portugal-online/uair-sat-hardware/schematics/uAir2_schematics.pdf

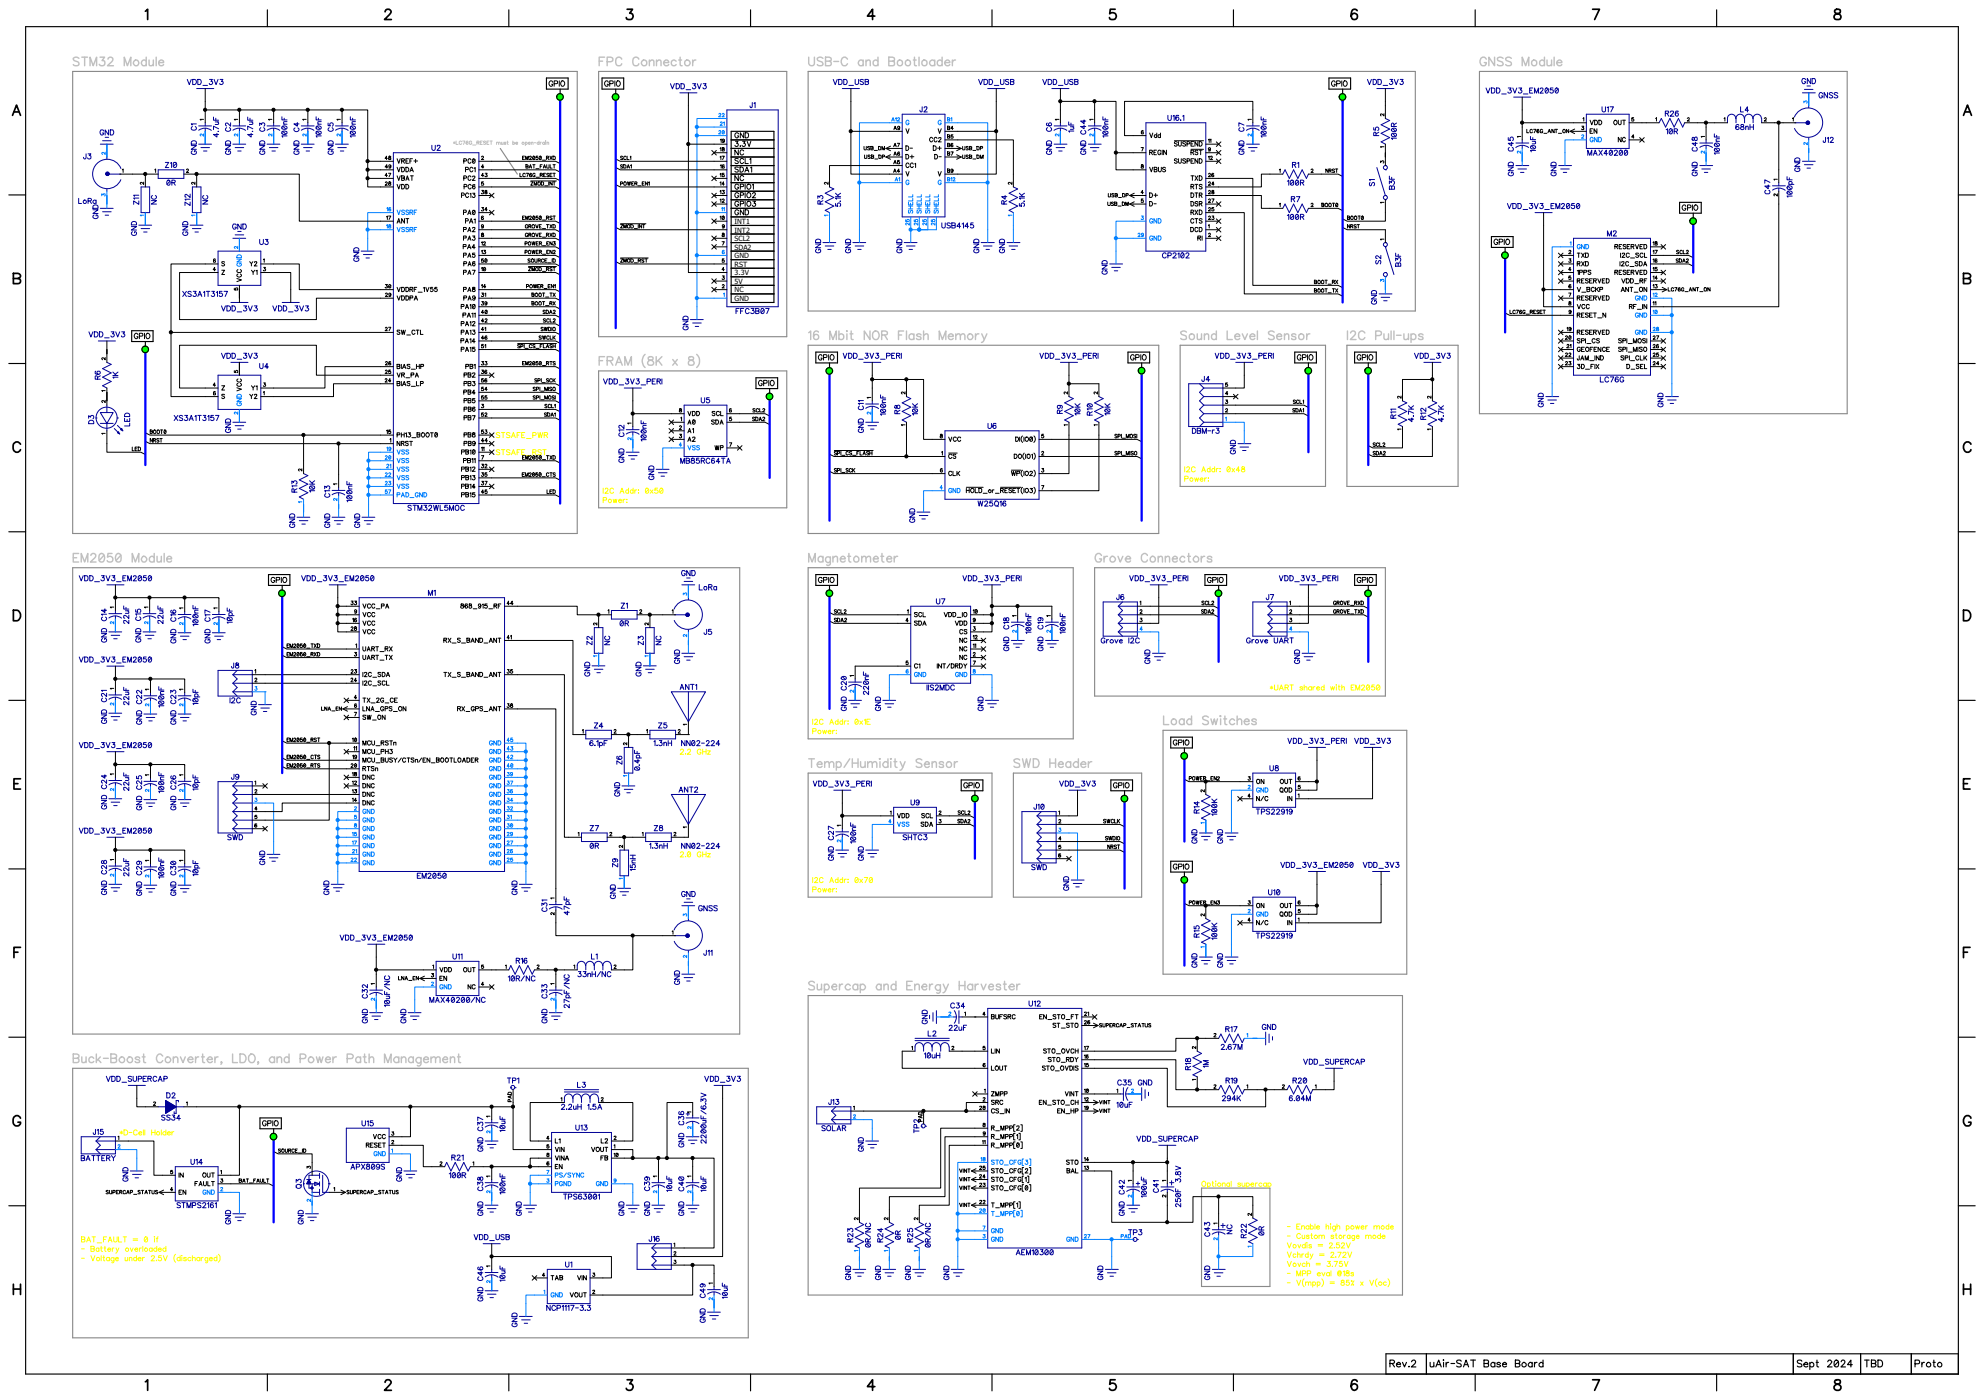
[picture p1: page 1]
INT1 INT2 SCL2 SDA2 GND RST 3.3V 5V NC GND
