portugal-online/uair-sat-hardware/docs/uAir-Sat Block Diagram Rev2.pdf

# uAir-Sat Rev2

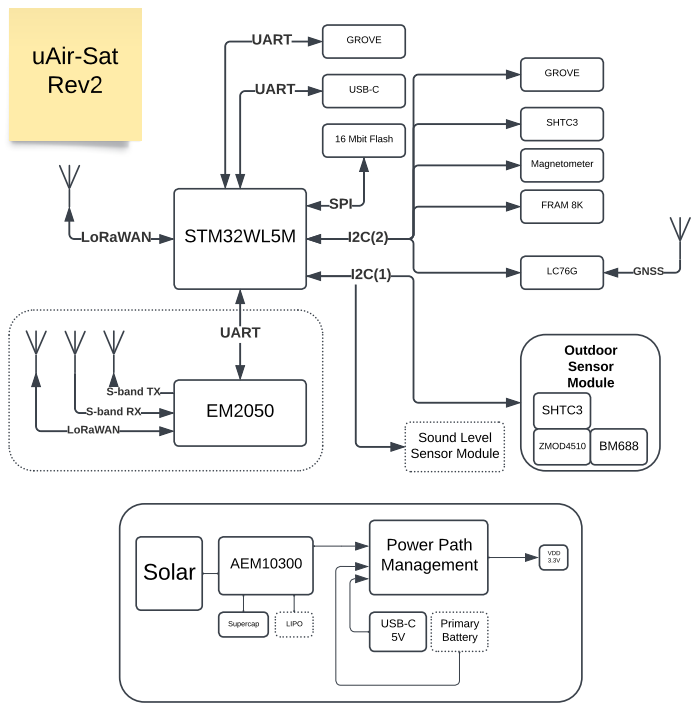
[picture p2: page 1]
Outdoor Sensor Module; STM32WL5M; Magnetometer; SHTC3; AEM10300; FRAM 8K; ZMOD4510; Solar; Supercap; Power Path Management; USB-C 5V; Primary Battery; VDD 3.3V; 16 Mbit Flash; SPI; UART; Sound Level Sensor Module; USB-C; LoRaWAN; S-band TX; S-band RX LoRaWAN; GNSS; GROVE; LIPO
