portugal-online/uair-sat-hardware/docs/uAir2-Sat_Rev2_bottom_view.pdf

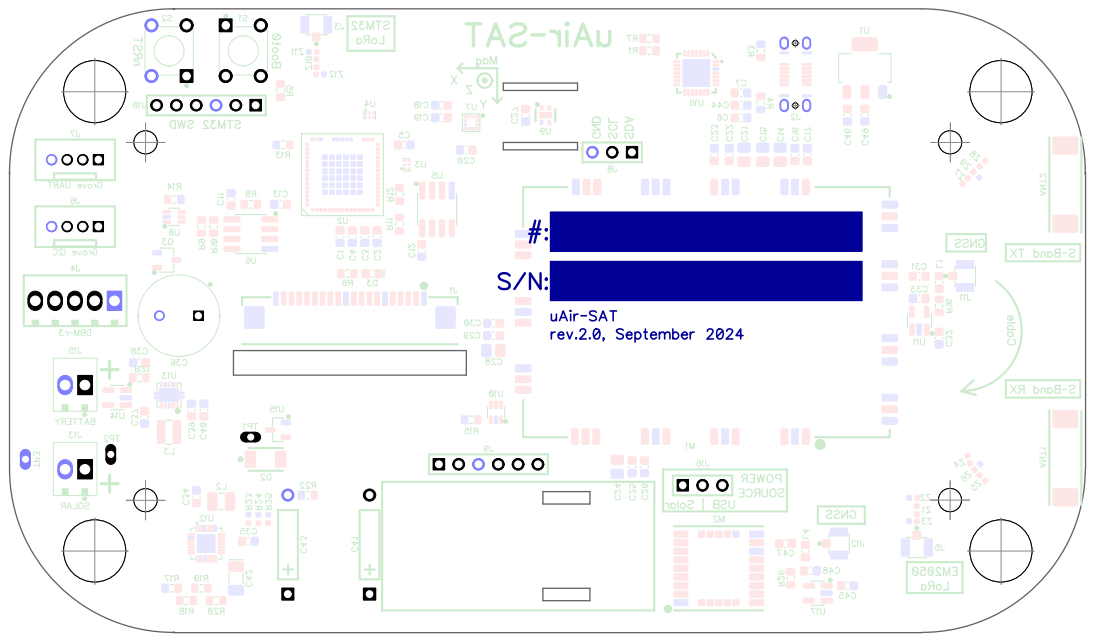
[picture p3: page 1]
