portugal-online/uair-sat-hardware/docs/uAir2-Sat_Rev2_top_view.pdf

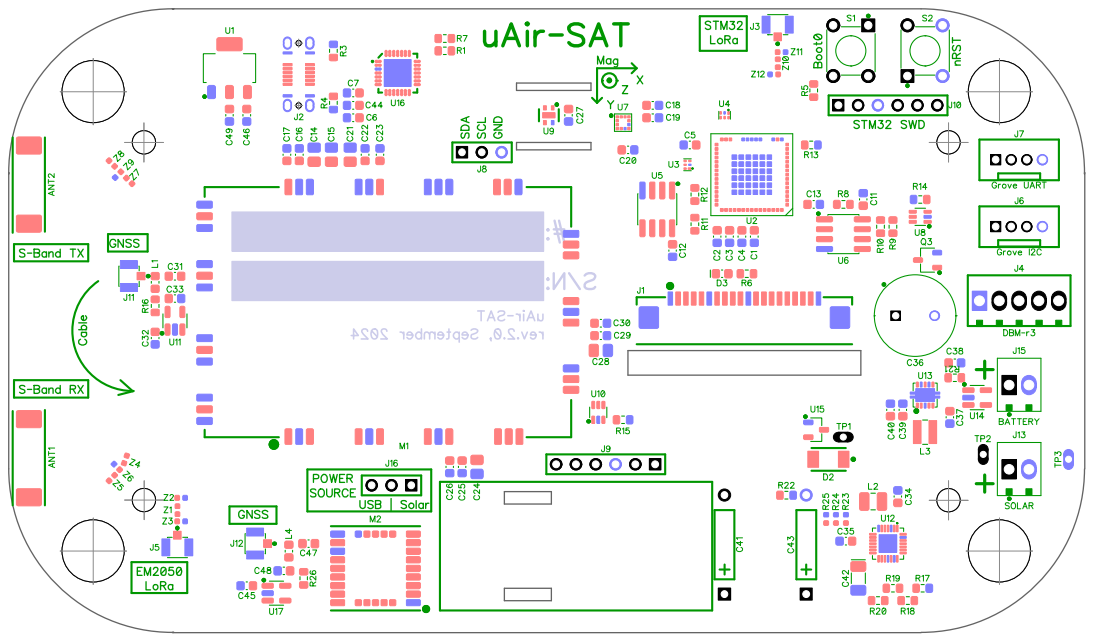
[picture p4: page 1]
