portugal-online/uair-sat-hardware/(list of files, drawings)

Other design files:
schematics/240A_uAir_rev2.dch
schematics/240A_uAir_rev2.dip
