portugal-online/uair-sat-hardware/docs/uair-sat-Rev1-full-assembled.pdf

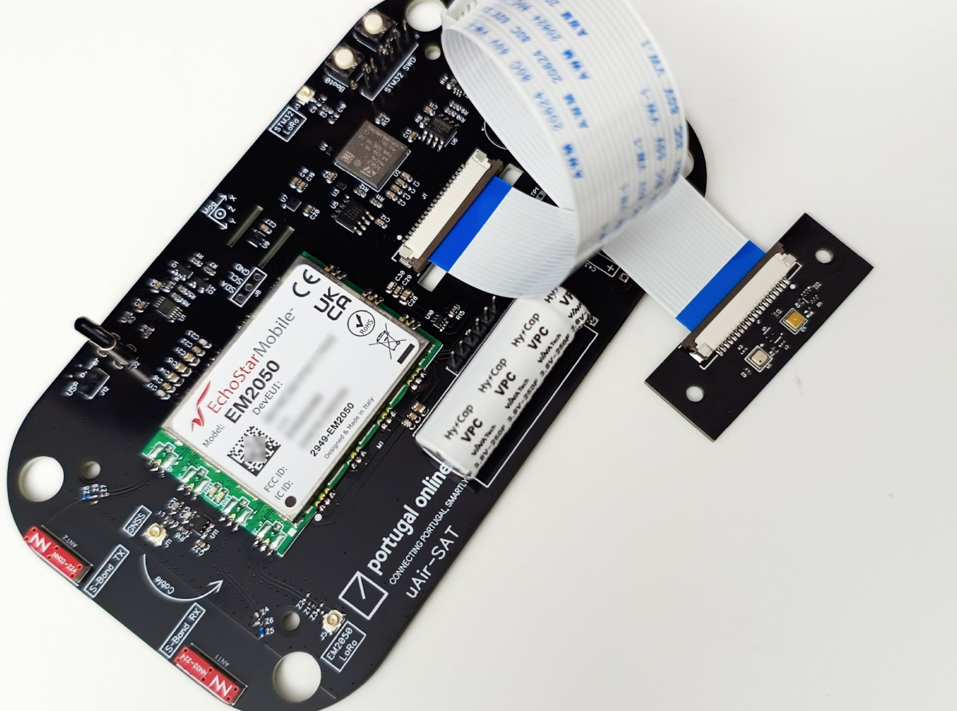
[picture p5: page 1]
