portugal-online/uair-sat-hardware/(commit log)

2025-10-23 uAir-Sat PCB Rev2 files
2025-10-23 Revise uAir-Sat documentation for clarity and detail
    Updated README to reflect new device architecture and features.
2025-10-23 Correct sensor names and update specifications
    Updated sensor and interface specifications in README.
2025-10-23 Update current consumption values in README
2025-10-25 Update sensor name from DBM-r3 to PCBA-DBM-PRO
2025-10-25 PCB design files
    Diptrace 5.x
    [240A_uAir_rev2.dch, 240A_uAir_rev2.dip]
